joelledevries/Electromagnetic-Accelerator/Hardware_setup.jpg

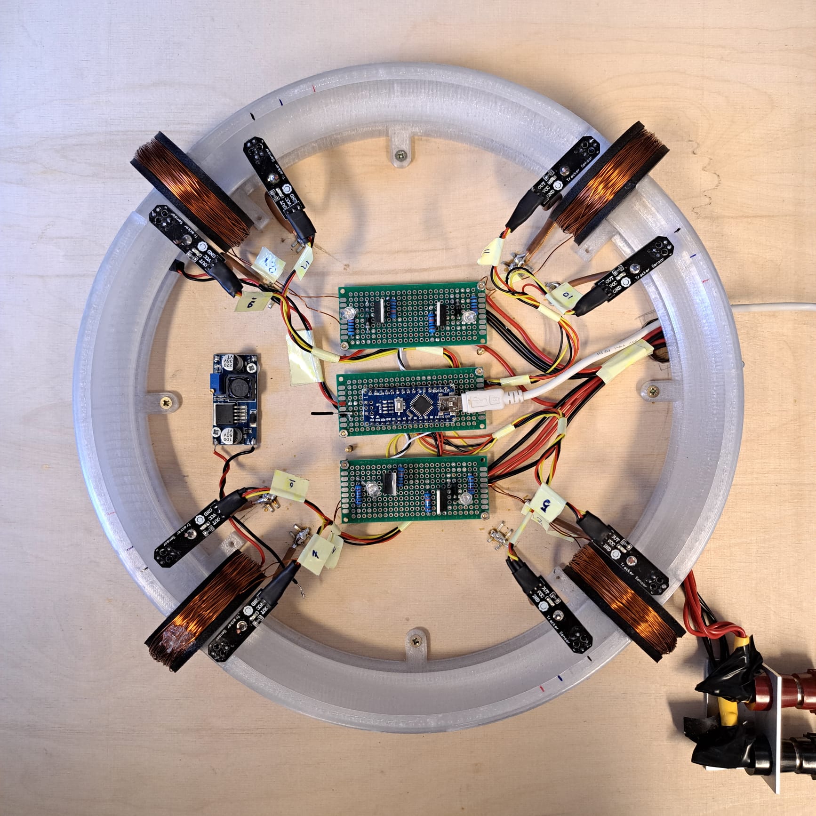
Hardware_setup.jpg
