joelledevries/Electromagnetic-Accelerator/README.md

# Electromagnetic-Accelerator
A project build in the first year of the bachelor Applied Physics.
